RockinRoel/standaert-ha/pcb/bom.md

# Bill of Materials

| Part id | Count | Description | Digikey link |
| --- | --- | --- | --- |
| R1 -- R32 | 32 | 1K 1W resistor | https://www.digikey.be/short/pq4j2f |
| R33 -- R66 | 34 | 1K 1/4W resistor | https://www.digikey.be/short/pq48zp |
| R67, R68 | 2 | 4.7K 1/4 W resistor | |
| D1 -- D32 | 32 | 1N400X diode, 1N4001 or higher (e.g. 1N4007) | https://www.digikey.be/short/pq4j2t |
| D33 -- D64 | 32 | 3mm LED | https://www.digikey.be/short/pq48pp |
| J1, J2 | 2 | DC power jack PJ-102AH | https://www.digikey.be/short/pq484m |
| J3, J4 | 2 | 2 pin male header or screw terminal, 2.54mm pitch | https://www.digikey.be/short/pq4jz3 |
| J5 | 1 | 10 pos. header | https://www.digikey.be/short/pq4jq1 | 
| J6 | 1 | 6 pin right angle connection header | https://www.digikey.be/short/pq489b |
| J7 -- J14 | 8 | 8 pin male header or screw terminal, 2.54mm pitch | https://www.digikey.be/short/pq4jmn |
| J15 | | Leave empty | |
| SW1 | 1 | SPDT slide switch | https://www.digikey.be/short/pq48mf |
| SW2 | 1 | Wire between MSB and 0 | |
| A1 | 1 | Arduino Nano | |
| A1 | 2 | female 15 pos. headers | https://www.digikey.be/short/pq48b5 |
| C1 -- C6 | 6 | 0.1 uF ceramic capacitor | https://www.digikey.be/short/pq4857 |
| U1 | 1 | CPC5001G opto-isolator | https://www.digikey.be/short/pq4j9z |
| U1 | 1 | 8 pos. socket | https://www.digikey.be/short/pq4j92 |
| U2, U7, U12, U13 | 4 | MCP23017 IO expander | https://www.digikey.be/short/pq4jcn |
| U2, U7, U12, U13 | 4 | 28 pos. socket | https://www.digikey.be/short/pq4j7b |
| U3 -- U6, U8 -- U11 | 8 | LTV-847 opto-isolator | https://www.digikey.be/short/pq4j54 |
| U3 -- U6, U8 -- U11 | 8 | 16 pos. socket | https://www.digikey.be/short/pq4jr7 |
