RockinRoel/standaert-ha/(list of files, drawings)

Other design files:
pcb/pcb.dsn
