RockinRoel/standaert-ha/controller/src/slip.cpp

#include "slip.hpp"

namespace StandaertHA {

namespace {

constexpr const uint8_t SLIP_ESC = 0xDB;
constexpr const uint8_t SLIP_ESC_END = 0xDC;
constexpr const uint8_t SLIP_ESC_ESC = 0xDD;

}

size_t slip_encode(const uint8_t * const in_buf,
                   const size_t in_size,
                   uint8_t * const out_buf,
                   const size_t out_size)
{
  size_t pos = 0;
  out_buf[pos++] = SLIP_END;

  for (size_t in_pos = 0; in_pos < in_size; ++in_pos) {
    const uint8_t b = in_buf[in_pos];
    if (b == SLIP_END) {
      out_buf[pos++] = SLIP_ESC;
      out_buf[pos++] = SLIP_ESC_END;
    } else if (b == SLIP_ESC) {
      out_buf[pos++] = SLIP_ESC;
      out_buf[pos++] = SLIP_ESC_ESC;
    } else {
      out_buf[pos++] = b;
    }
  }

  out_buf[pos++] = SLIP_END;
  return pos;
}

size_t slip_decode(const uint8_t * const in_buf,
                   const size_t in_size,
                   uint8_t * const out_buf,
                   const size_t out_size)
{
  size_t in_pos = 1;
  size_t pos = 0;
  while (in_pos < in_size &&
         in_buf[in_pos] != SLIP_END) {
    if (in_buf[in_pos] == SLIP_ESC) {
        ++in_pos;
        if (in_buf[in_pos] == SLIP_ESC_END) {
            out_buf[pos++] = SLIP_END;
        } else if (in_buf[in_pos] == SLIP_ESC_ESC) {
            out_buf[pos++] = SLIP_ESC;
        } else {
            // TODO: error?
        }
    } else {
        out_buf[pos++] = in_buf[in_pos];
    }
    ++in_pos;
  }
  return pos;
}

}
