RockinRoel/standaert-ha/(commit log)

2017-01-14 Made it cross-compilable for Raspberry Pi with static libs
2017-01-15 Added a little I2C test (MCP23017 @ 0x20, Raspberry Pi B first gen)
2017-01-15 Take exclusive lock in i2c test
2017-12-28 Added CheckLinuxI2C, I2CBusDevice
2017-12-28 Added MCP23017 code + test and Fritzing schema
    [sketch.fzz]
2017-12-28 Updated PCB
    [sketch.fzz]
2017-12-29 Added KiCad files
    [i2clevel.sch, input.sch, output.sch, pcb.kicad_pcb, pcb.sch]
2018-12-30 Updating PCB
    [i2clevel.sch, input.sch, opto.sch, out_with_led.sch, output.sch, pcb.dsn, pcb.sch, sketch.fzz]
2019-01-13 4 layer PCB
    [opto.sch, pcb.kicad_pcb, pcb.sch]
2019-01-26 Use pcb.lib using relative path
2019-01-26 Cleaning up some traces
    [pcb.kicad_pcb]
2019-01-27 Silkscreen/tweaks/MSB switch/I2C header
    [input.sch, opto.sch, out_with_led.sch, output.sch, pcb.kicad_pcb, pcb.sch]
2019-01-27 refill etc.
    [pcb.kicad_pcb]
2019-01-27 Tweak some traces
    [pcb.kicad_pcb]
2019-02-08 Changed some footprints, spacing out components
    [input.sch, opto.sch, out_with_led.sch, pcb.kicad_pcb, pcb.sch]
2019-02-08 Silkscreen tweaks etc.
    [pcb.kicad_pcb]
2019-02-08 Some traces done
    [pcb.kicad_pcb]
2019-02-08 Silkscreen, positioning, rounded corners
    [pcb.kicad_pcb]
2019-02-09 version that went into production
    [pcb.kicad_pcb, pcb.sch]
2019-02-09 Added gerber zip
2019-02-26 Added bill of materials
2019-03-03 Switching outputs to be the right way round
2019-03-03 Config, refactoring
    Could be compile time if constexpr didn't trigger a compilation fault
    [command.h, config.cpp, config.h, main.cpp, slip.cpp]
2019-03-03 Larger receive buffer for commands, fixed serial code
    [main.cpp]
2019-08-04 Adding logger, config, command line args, debugging output, cross-compile instructions
    Basic structure for MQTT configurations
    Currently hangs in for n in notifications {}
2020-08-13 Controller: use GCC 7 with newer toolchain, enable C++17
    This allows us to remove BUGGED_COMPILED ifdefs, and move constexpr
    config to headers (not sure if that really does much, though).
    [config.cpp, config.h]
2020-08-13 Added support for Nano Every board
    Compiles, but not actually tested, since I don't have a Nano Every.
2020-08-13 Controller: switched to using a DSL for config
    With C++17 this is also testable @ compile time (constexpr), and it
    saves working memory while not having a meaningful impact on processing
    time.
2020-08-15 Fixed command docs, type now can take 3 bits
    [command.hpp]
